atlesque/winterlight/docs/screenshots/measure/desktop-entered.jpg

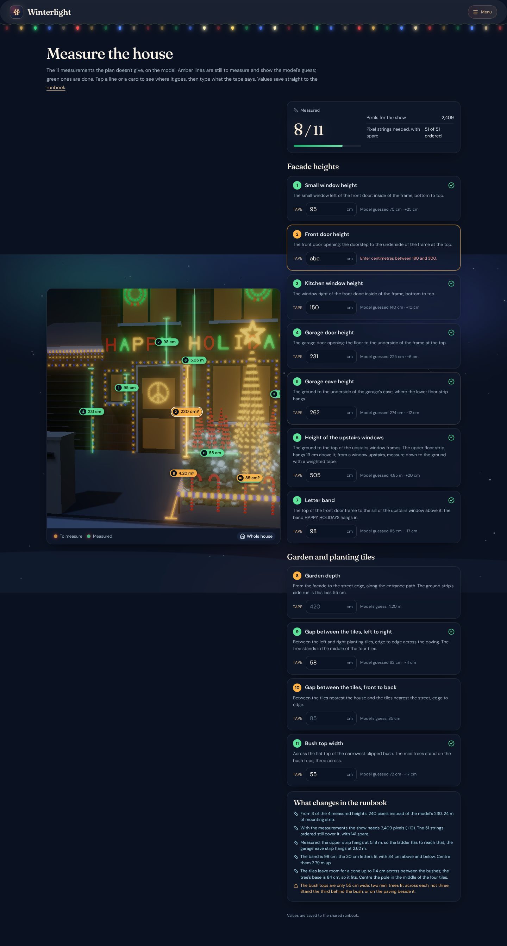
docs/screenshots/measure/desktop-entered.jpg
