atlesque/winterlight/docs/screenshots/wiring/menu-phone.jpg

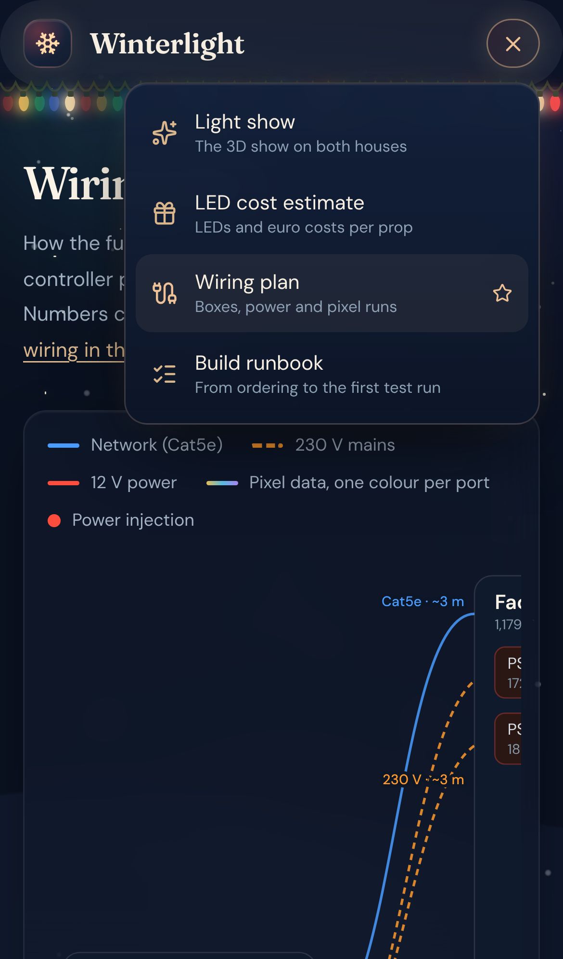
docs/screenshots/wiring/menu-phone.jpg
