atlesque/winterlight/README.md

# Winterlight

A Christmas light show for an 8.50 m Belgian brick-house facade, synced to *Wizards in Winter*. Our house carries the [original filmed house](/?house=original)'s props one for one (all 56 channels) and runs the original's detected timing, so both houses play the same show.

Where they sit (`src/house.js`, geometry in `src/props.js`): yellow/blue icicle strips along the top edge of the two upper windows and under the garage eave (upper and lower floor strips), outlines round the small left window, the door frame, the kitchen window and the garage door (window strips), HAPPY HOLIDAYS in the band between the door and the upper windows, the two circles each in one pane of the upper windows, the peace sign on the front door, a 2.5 m wireframe tree with its star between the planting tiles, eleven mini trees between the facade and the tiles, eight candy canes along the street edge and the ground strip along the left side and front of the shrubbery.

## Run and view

```bash
npm install
npm run dev
```

Open the reported local URL. Both houses live on one page; the toggle in the header shows **Our house**, the **Original** house, or a **Split view** with the original on top and ours below. The choice is kept in the URL (`?house=original`, `?house=split`; our house is the default), and `/original.html` redirects to `/?house=original`. Both houses run one player (`app/composables/useShowPlayer.js`): the original video (or its soundtrack) is the clock, the lights follow `outputs/original-house-cues.json`, and the side panel has the light intensity, all-props-on switch and per-channel board. The view buttons move both cameras. **Overlay video** lays the original model's lights over the original video, so it only shows when the original house is on screen (in split view it overlays the top pane).

The interface is a Nuxt 4 app with Nuxt UI (`app/`): `app/pages/index.vue` is the show page, `app/pages/costs.vue` the LED cost page, `app/pages/runbook.vue` the build runbook, `app/composables/useShowPlayer.js` the shared player, and `app/components/` the header, the prop board and the festive decorations (snow, stars, aurora and the fairy-light garland, which stand still for visitors who prefer reduced motion). The 3D scenes, layouts, cues and cost model stay plain modules in `src/`, so the tests and tools read them as before. `npm run build` runs `nuxt generate`, which prerenders every page (with its SEO tags) into static files in `dist/`, the folder `wrangler.jsonc` serves; `outputs/` is copied to `dist/outputs/`. Fonts (Fraunces and DM Sans) are self-hosted from `@fontsource` packages, so builds need no font service.

The hosted site is [Winterlight](https://winterlight.alexander-df0.workers.dev). Deploy through `npm run deploy`; `npm run deploy:check` builds and checks packaging without publishing. It uses Cloudflare Workers Static Assets, with a small Worker (`worker/index.js`) that only handles `/api/*` for the runbook's shared ticks in a D1 database. Pushes to `main` deploy automatically through Workers Builds, and other branches get a Preview URL through `wrangler preview` using the empty `previews` block in `wrangler.jsonc`.

## Earlier layouts

The old facade layout (arches, stars, poles and outlines, mapped in `outputs/legacy-facade/pixel-map.csv`), its MIDI note show and its extracted `.wltiming` show have been retired from the page; their output files stay in `outputs/` for reference and the code is in git history.

## Original house

The **Original** house (`src/original/scene.js`) rebuilds the house from the filmed show as its own 3D scene, separate from the facade model above, so the original show can be reverse-engineered prop by prop. Its props and how they are addressed:

| Prop | Channels |
|---|---|
| Upper and lower floor strips (yellow/blue) | one per floor |
| Window strips (yellow/blue) | one group |
| HAPPY HOLIDAYS letters (red, green, yellow) | one per letter (13) |
| Christmas circles | left, right |
| Candy canes | one per cane (8) |
| Mini trees | one per tree (11) |
| Ground strip, 30 cm high (yellow/blue) | one |
| Peace sign | one |
| Wireframe tree | one per vertical strip (16) + star |

All 56 channels are described once in `src/original/layout.js`, in the pixel coordinates of a reference still of the final all-on frame (a 2× crop of the video). The 3D model and the detector both read that file. Counts of canes, mini trees and tree strips are estimates from the still.

Because the original video is filmed from a fixed camera, `tools/original/detect.py` samples each channel's region on every decoded frame, learns that channel's own off and on brightness over the whole video, and records each frame's brightness between them in 5% steps, so the show's fades come through rather than being flattened to on/off. The wireframe tree's strips and star are the exception: they only switch on and off, so they are stored at full level. Each strip is read as the average over its wedge of the cone, and only counts as lit when it reaches 60% of the brightest strip in that frame, so glow from a lit strip doesn't switch on its neighbours. Multicolour strips are also classified as yellow, blue or both. There is no smoothing or resampling, so cue changes land on exact video frames (29.97 fps). The page plays them against the hosted soundtrack, which was extracted from the same video.

```bash
# Check the regions against a frame of the video, then detect a range.
python3 -I tools/original/detect.py source.mp4 --overlay work/original/overlay.png --at 180
python3 -I tools/original/detect.py source.mp4 --out outputs/original-house-cues.json --levels work/original/levels.csv
```

Light spills between neighbouring props, so each channel has a floor below which it counts as off: 10% for the floor strips, 25% for the canes and circles, 50% for the letters (they catch up to ~46% spill from the icicles above) and 45% for the ground strip (snow lit by the icicles and mini trees). The mini trees stand closer together than their glow is wide, so each is watched along its centre line by mean brightness with a 45% floor. The window-strip regions stop short of the icicles, and the peace sign is watched only along its upper half, above the mini-tree tops, for the same reason. `outputs/original-house-cues.json` covers the whole video, 0:00–3:05 (all 5,569 frames).

The side panel plays the original video with its own sound, and while it plays the lights follow the frame on screen (`src/original/video-clock.js`). The site hosts a 720p copy at `public/media/wizards-in-winter-video.mp4` (about 13 MB, every source frame and timestamp kept). If it is ever missing, the page asks for a local MP4 once and keeps it in that browser, and without any video the hosted soundtrack drives the lights. The hosted copy was made with:

```bash
ffmpeg -i source.mp4 -map 0:v:0 -map 0:a:0 -vf scale=1280:720:flags=lanczos -c:v libx264 -preset slow -crf 27 -pix_fmt yuv420p -fps_mode passthrough -c:a aac -b:a 96k -movflags +faststart public/media/wizards-in-winter-video.mp4
```

Seen from the camera, tree strips at angle θ and π−θ (front and back of the cone) overlap, so detection reads seven lines across the tree and lights both strips of each lit line. In the video the light goes round the cone: a 60° slice chases round it (1:17–1:29, 2:12–2:26, 2:30–2:52), four or two arms turn together (2:53–3:02), and short sweeps start as two points on one side that run round the front and the back and meet on the other to light the whole tree. `tools/original/tree_motion.py` (run by the detector, or on its own over a cue file) gives each passage of twelve or more changes that motion: it fits a slice or evenly spaced arms turning round the cone, steadily in one direction, and lights in each frame the strips nearest that pattern that still look exactly like the video from the front. Shorter passages keep both sides lit, so the two points run round the front and the back. Which way the light turns can't be seen from the front (a pattern turning one way looks like its mirror image turning the other), so the front moving left to right is taken.

## Current deliverables

- [Approved build guide](outputs/christmas-show-project.md) and [printable HTML](outputs/christmas-show-project.html)
- [Facade/plan layout](outputs/layout.svg) and [wiring diagram](outputs/wiring.svg)
- [Pixel/channel map](outputs/legacy-facade/pixel-map.csv), [controller port settings](outputs/controller-config.csv) and [power feed schedule](outputs/power-feeds.csv)
- [Revised parts checklist](outputs/revised-bom.csv) and [parts review](outputs/parts-critical-review.md)
- [Sourcing and cost changes](outputs/eu-sourcing-research.md) and [technical research](outputs/technical-research.md)
- [Playback guide](outputs/source-playback-guide.md), [sampling provenance](outputs/source-mapping.json), [every-frame worksheet](outputs/source-frame-summary.csv) and [cue assignments](outputs/cue-worksheet.csv)
- [Integrity report](outputs/source-integrity-report.json), [bank manifest](outputs/controller-banks/manifest.json) and [playback audit](outputs/source-playback-audit.json)

Historical price/regulatory research is dated explicitly; it is not a current delivered purchase quote. Prior screenshots depict earlier revisions unless identified as the approved facade edition.

## Rebuild and validate

```bash
npm test
npm run build
```

## LED cost estimate

`/costs.html` recommends LEDs for every prop of our house and prices them in euro per prop, per group and in total, including wiring, power injection, controllers, power supplies, boxes and the show computer. Ticking props or groups off updates every total. Pixel counts, frame lengths and cable runs come from `src/props.js`; parts and prices (with shop links and the date they were checked) live in `src/costs/catalog.js`, the cost model in `src/costs/estimate.js` and the page in `app/pages/costs.vue`.

## Build runbook

`/runbook.html` is the step-by-step plan for building the show for real: plan and measure, order the parts (in two waves, with order-by dates), deliveries, a bench test, building the props, hanging and placing them, configuring Falcon Player and xLights, and a test run before show night. Each purchase links to its shop, is tagged as a private or business expense (click the tag to switch it) and adds to the private and business subtotals. The measuring steps list the lengths the 2021 plan gives (everything along the facade and the garden's width, via `src/house.js`) and the ones it can't (heights, the forecourt depth and the planting tiles), with the model's guess to check with a tape. Ticks and tag switches are shared across devices: the page reads and writes `/api/runbook`, which `worker/index.js` serves from the `winterlight` D1 database (`RUNBOOK_DB`, schema in `migrations/`). The runbook page, the measure page and their API (`/runbook`, `/runbook.html`, `/measure`, `/measure.html`, `/api/runbook`) sit behind the Cloudflare Access application **Winterlight runbook**, which only lets Alex's email in (one-time PIN); the Worker also refuses requests that lack the identity header Access adds. The rest of the site stays public. Orders already placed and decisions already made (`PRESET` in `src/runbook/runbook.js`) start ticked; the database only stores changes to those defaults. Without the Worker (`npm run dev`, preview builds) the page keeps ticks in the browser instead. To try the API locally, put `RUNBOOK_OPEN=1` in `.dev.vars` (no Access locally), run `npx wrangler d1 migrations apply winterlight --local`, `npm run build` and `npx wrangler dev`. `/measure.html` shows every measurement still to take with a tape (opening heights, the upstairs windows, the garage eave, the letter band, the garden depth, the gaps between the planting tiles and the bush tops) as dimension lines on the 3D model, amber with the model's guess until measured and green after. Tap a line or a card to fly the camera to it and type the value in centimetres. Values are stored in the same D1 database (`measurements` table, `migrations/0002_measurements.sql`) through `/api/runbook`; the measurements, their positions on the model and what they change live in `src/measures/measures.js`. In the runbook a measuring step ticks itself once all its values are in, its tape lines show the measured values, and the steps that depend on them show the updated numbers: the window outline and ground strip pixel counts, whether the pixel strings and mounting strip ordered still cover the show, the ladder height, and whether the letters, the tree and the mini trees fit. Quantities come from the cost model for the full show, in the units the shops sell; the chapters, shops, delivery times and expense tags live in `src/runbook/runbook.js` and the page in `app/pages/runbook.vue`.

The coro props (Christmas circles, peace sign, candy canes and tree star) have full-size cutting templates in `outputs/templates/` (SVG and PDF, one per shape, with every 12 mm pixel hole marked and a 100 mm bar to check the print scale), linked from the runbook's build chapter. They are drawn from the same bulbs and frames as the 3D model; regenerate them after a prop changes with `node tools/templates/make.mjs` (the PDFs need Playwright). The HAPPY HOLIDAYS letters are ProPixeler's ready-made 30 cm coro letters, so they have no template.

## Show software

`/software.html` explains the software side of the real show with one data diagram: the Raspberry Pi running Falcon Player in the garage, the switch, the two Baldrick 8 controllers (facade board and garden box), the USB sound card and FM transmitter, and the laptop, home router and this site, which are only used for setup. It lists what runs where and lays out the proposed conversion from the detected cue file to a Falcon Player sequence (`.fseq` at 40 fps, one RGB channel block per controller over DDP), with each step marked done, decided or proposal, and what is still to decide. Controllers, ports and pixel counts come from the wiring plan; the channel map and sequence numbers are worked out in `src/software/plan.js`, and `tests/software.test.js` checks them against the cue file. The page is public.

## 3D prints

`/print.html` lists the PETG parts the garden props still need, for the Bambu Lab A1 (256 mm bed): base rings and top caps for the mini trees; the wireframe tree's crown hub, star holder and a base ring of 16 puzzle segments, four of them with a brick tray; a two-brick base per candy cane; and a brick foot and post for every ground strip post. The paving in front of the house is stone, so nothing is staked: the props stand on printed trays weighed down with concrete paving bricks (22 × 11 × 8 cm), the tree's pole in a parasol base, and only the mini trees push a rod into their bush. The 3D view shows each finished prop (`src/print/assembly.js`: the printed parts where they sit once built, with the strip, coro, pixels, bricks and pole) or each part on the bed as it prints.

Each part is an OpenSCAD file in `tools/print/` (shared channel, tray and ring code in `lib.scad`); `src/print/parts.js` says how many to print and passes the model's sizes (tree radius and height, mini-tree size, strip height) in as `-D` overrides, so the parts follow `src/house.js`. `node tools/print/make.mjs` (needs `openscad`, and `zip` for the bundle) renders `outputs/print/<part>.stl`, a copy of each `.scad` with those values filled in, `manifest.json` (size and grams) and `winterlight-prints.zip`, and refuses a part bigger than the bed. The slots are drawn for a 25 × 2 mm mounting strip, 3 mm coro, a 32 mm pole and 22 × 11 × 8 cm bricks; change `strip_w`, `strip_t`, `pole_d` or the brick size once those are measured and render again. The page is public: it isn't behind the runbook's Access application, and the runbook's build and placing steps link to it.

## SEO and sharing preview

`app/pages/index.vue` sets (with `useHead`/`useSeoMeta`, prerendered into the HTML) the title, description, canonical URL, Open Graph and Twitter card tags; the page swaps `document.title` as the house toggle changes. `public/original.html` is only a redirect to `/?house=original` with a canonical link there. `public/og-image.jpg` (our house) and `public/og-image-original.jpg` (the original house) are 1200×630 renders of the site's own 3D scenes. The pages also share `favicon.svg`, `apple-touch-icon.png`, `robots.txt` and `sitemap.xml`.

To regenerate the share images after a model changes: `npm run build`, start `npm run preview` (serves `dist/` on port 4173), then run `node tools/og-image/render.mjs` (needs Playwright). The page list, show moment and card text live at the top of that script; the card layout is `tools/og-image/card.html`.

To add a new page: add a Vue file under `app/pages/`, copy the `useHead`/`useSeoMeta` block from `app/pages/index.vue`, change the title, description, canonical, `og:url`, `og:title`, `og:description` and the two `twitter:` text tags, add the page to `tools/og-image/render.mjs` if it should have its own image, add its URL to `public/sitemap.xml` and its route to `nitro.prerender.routes` in `nuxt.config.ts`.
