atlesque/winterlight/tools/transcription/requirements-desktop.txt

# Torch is reused from the desktop CUDA runtime; never install model weights here.
numpy==2.4.6
scipy==1.17.1
librosa==0.11.0
soundfile==0.13.1
pretty-midi==0.2.11.post0
mir-eval==0.8.2
mido==1.3.3
transformers==4.43.4
huggingface-hub==0.36.2
onnxruntime==1.31.0
ml-collections
beartype
rotary-embedding-torch
einops
absl-py
soxr
safetensors
PyYAML
tqdm
julius
lameenc
openunmix
dora-search
omegaconf
hydra-core
hatchling
setuptools
wheel
resampy

matplotlib
torchlibrosa==0.1.0
