atlesque/winterlight/outputs/approved-facade-playing.png

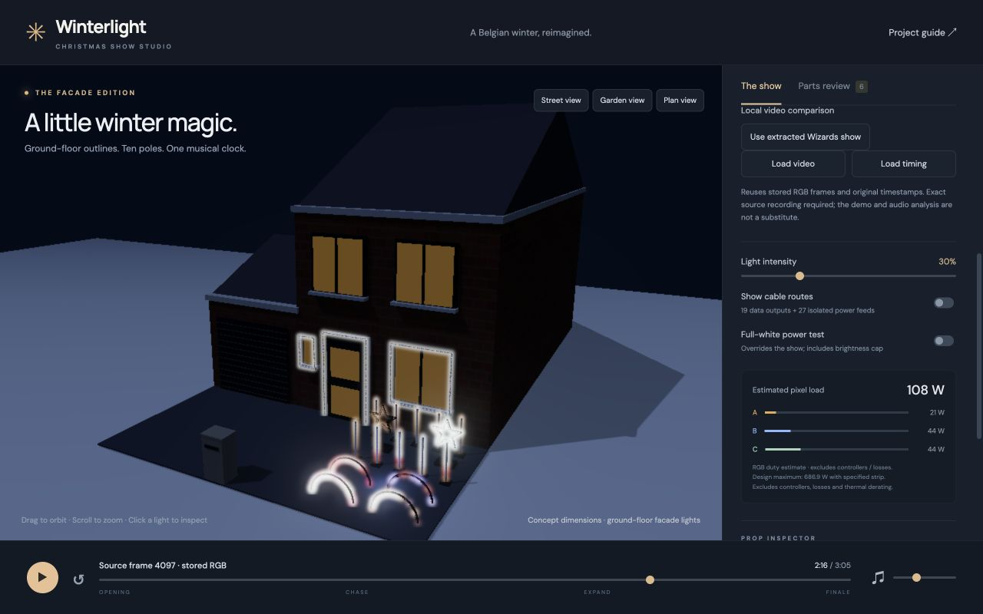
outputs/approved-facade-playing.png
