atlesque/winterlight/outputs/cloudflare-preview.jpg

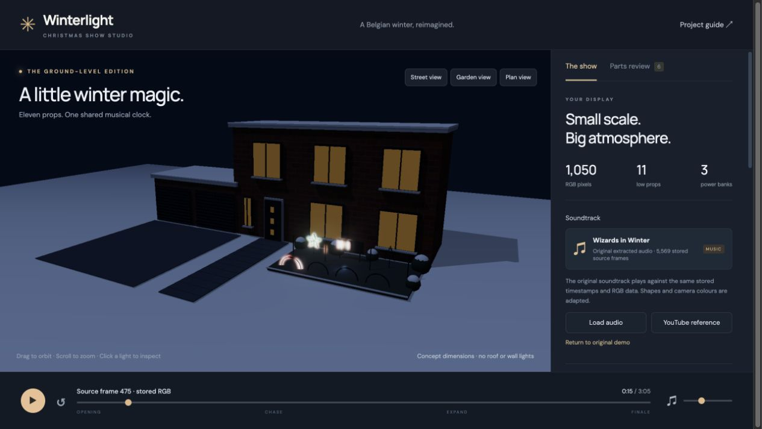
outputs/cloudflare-preview.jpg
