atlesque/winterlight/outputs/house-plan-preview.jpg

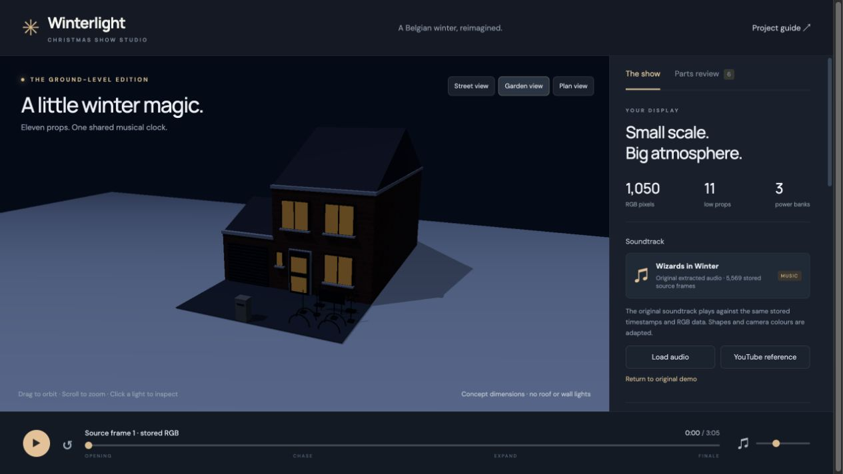
outputs/house-plan-preview.jpg
