atlesque/winterlight/outputs/new-props-preview.png

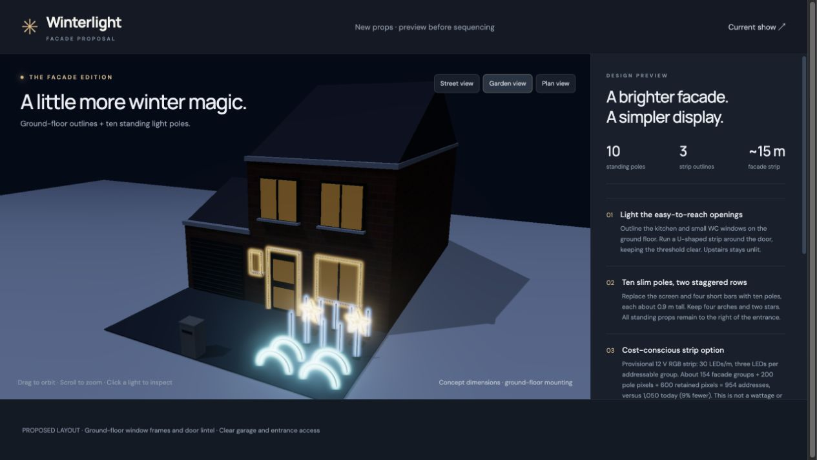
outputs/new-props-preview.png
