atlesque/winterlight/outputs/simulator-preview.jpg

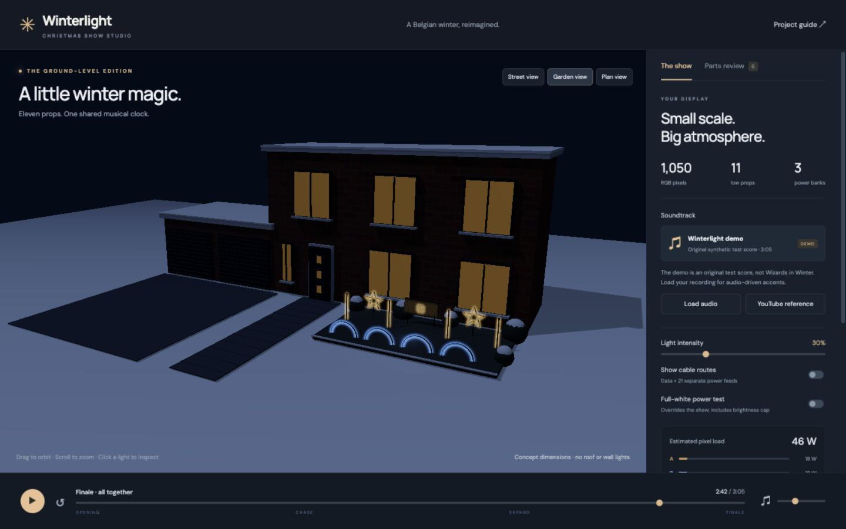
outputs/simulator-preview.jpg
