atlesque/winterlight/outputs/source-show-preview.jpg

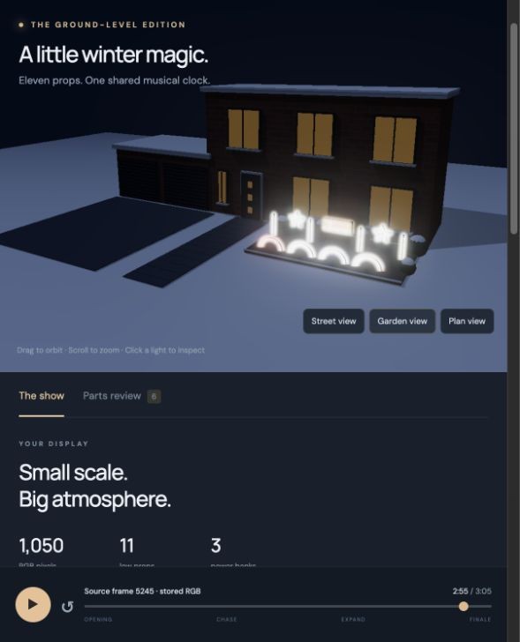
outputs/source-show-preview.jpg
