atlesque/winterlight/outputs/source-timing-diagnostic.jpg

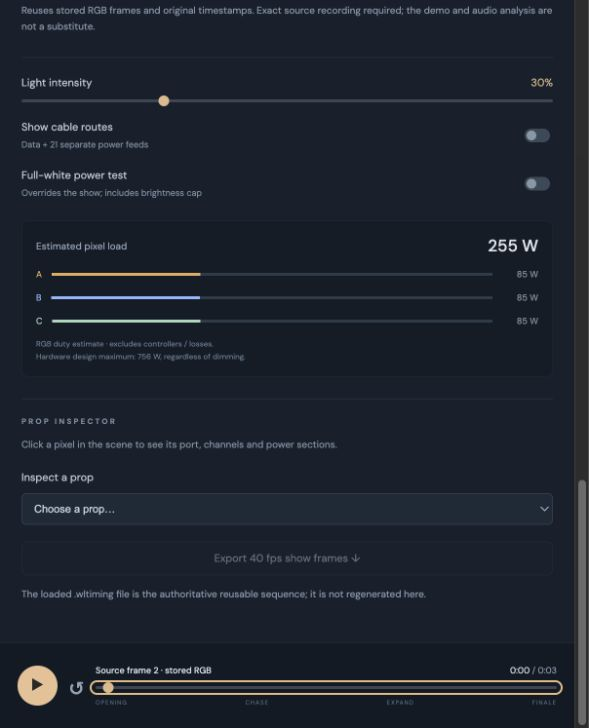
outputs/source-timing-diagnostic.jpg
