atlesque/winterlight/outputs/timing-integrity-rejection.jpg

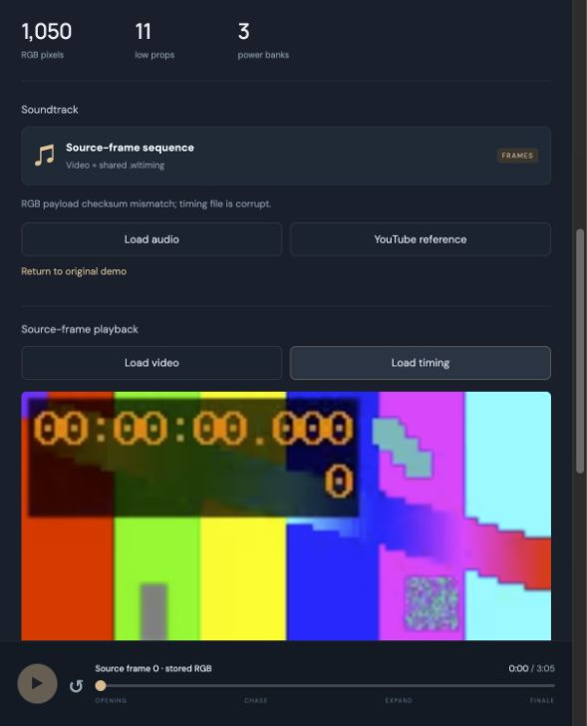
outputs/timing-integrity-rejection.jpg
