atlesque/winterlight/public/og-image-original.jpg

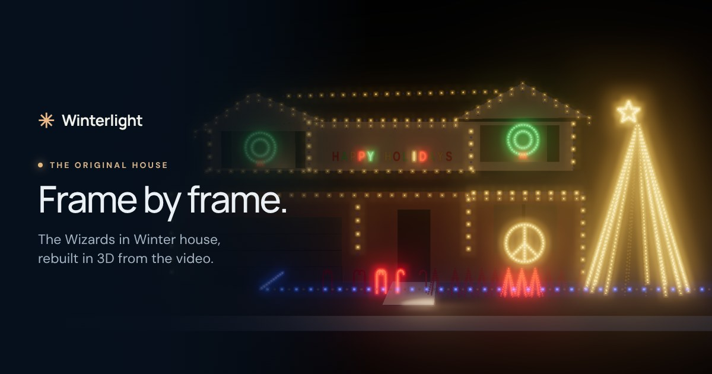
public/og-image-original.jpg
