atlesque/winterlight/public/og-image.jpg

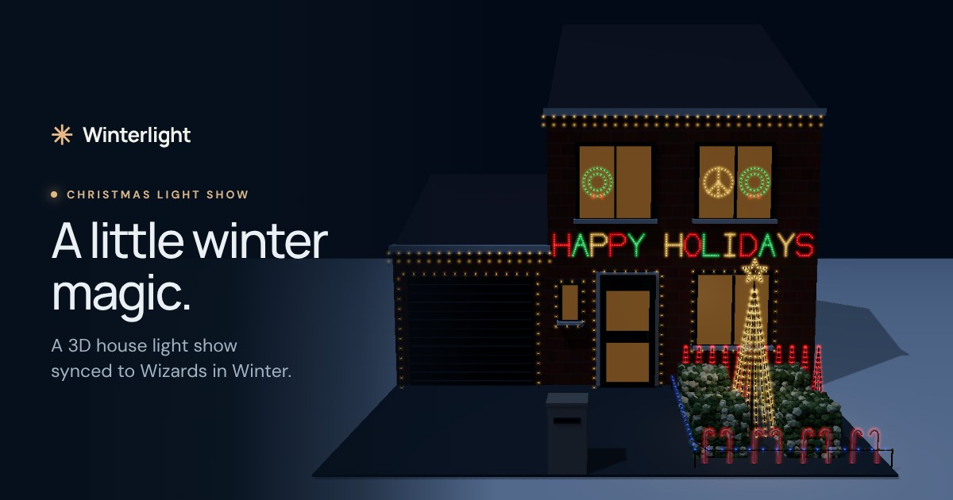
public/og-image.jpg
