atlesque/winterlight/outputs/print/minitree-base.stl

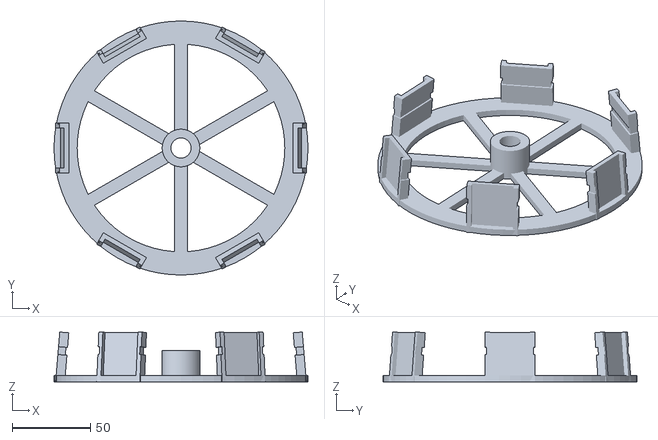
[picture p13: CAD file, 2026-11-13]
outputs/print/minitree-base.stl
162.0 x 162.0 x 31.9
