atlesque/winterlight/outputs/print/fence-post.stl

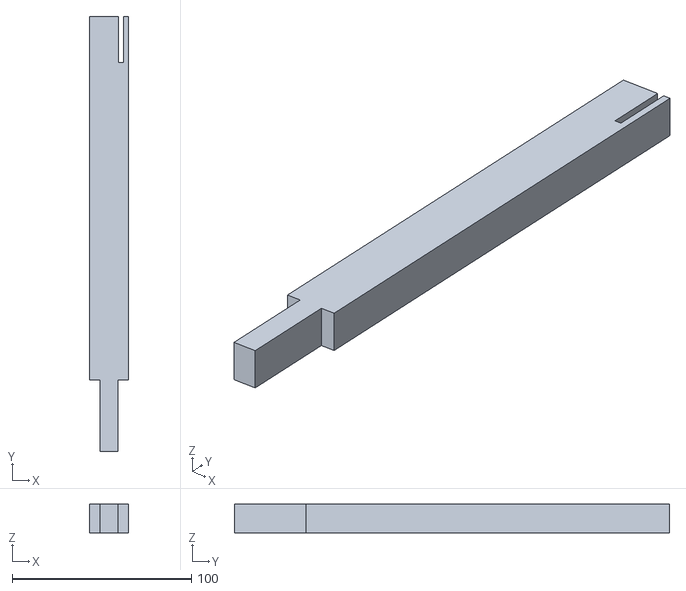
[picture p14: CAD file, 2026-11-07]
outputs/print/fence-post.stl
22.0 x 242.9 x 16.0
