atlesque/winterlight/outputs/print/tree-ring.stl

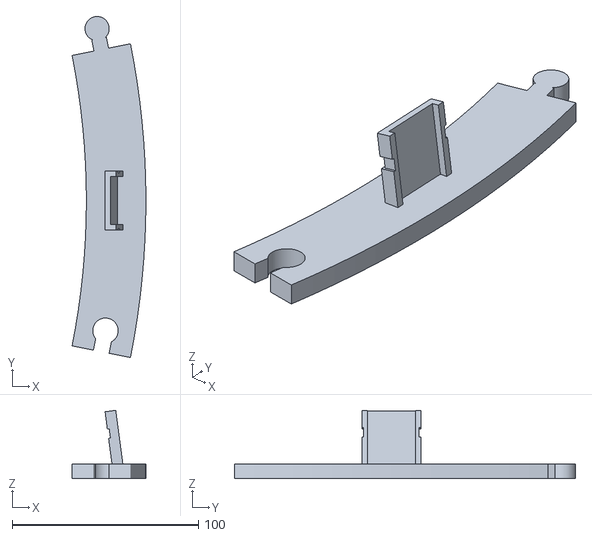
[picture p15: CAD file, 2026-11-07]
outputs/print/tree-ring.stl
39.7 x 183.2 x 36.7
