atlesque/winterlight/outputs/print/tree-crown.stl

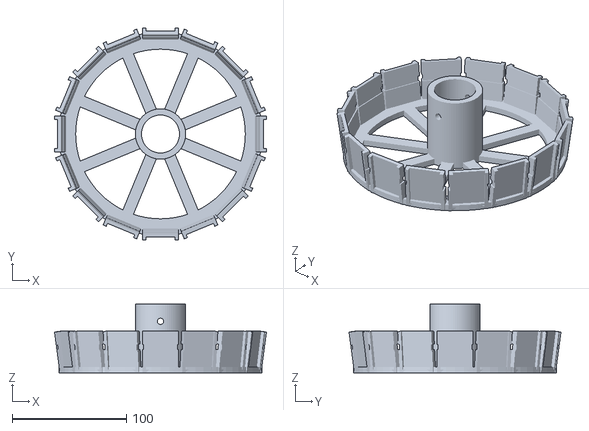
[picture p16: CAD file, 2026-11-07]
outputs/print/tree-crown.stl
185.5 x 185.5 x 60.0
