atlesque/winterlight/outputs/print/cane-base.stl

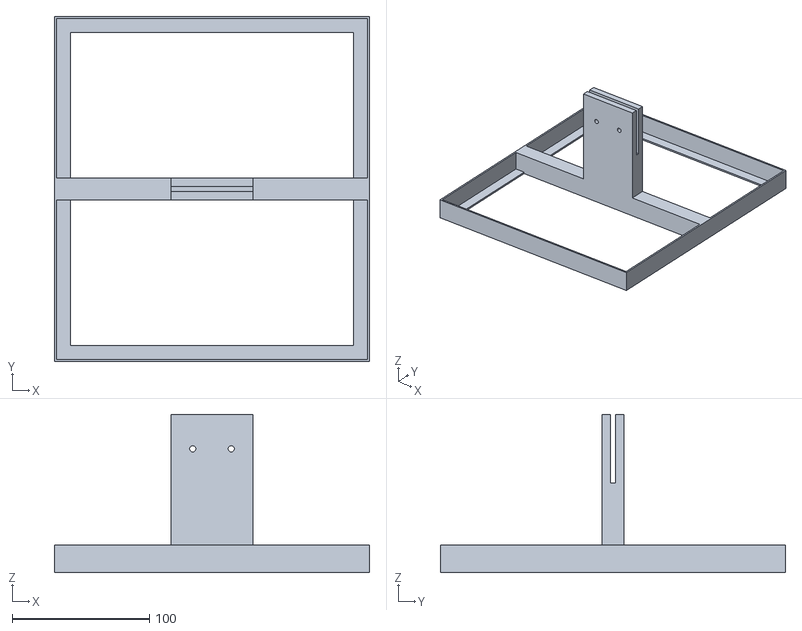
[picture p17: CAD file, 2026-11-07]
outputs/print/cane-base.stl
229.2 x 251.2 x 115.0
