atlesque/winterlight/docs/screenshots/wiring/garage-open-street.jpg

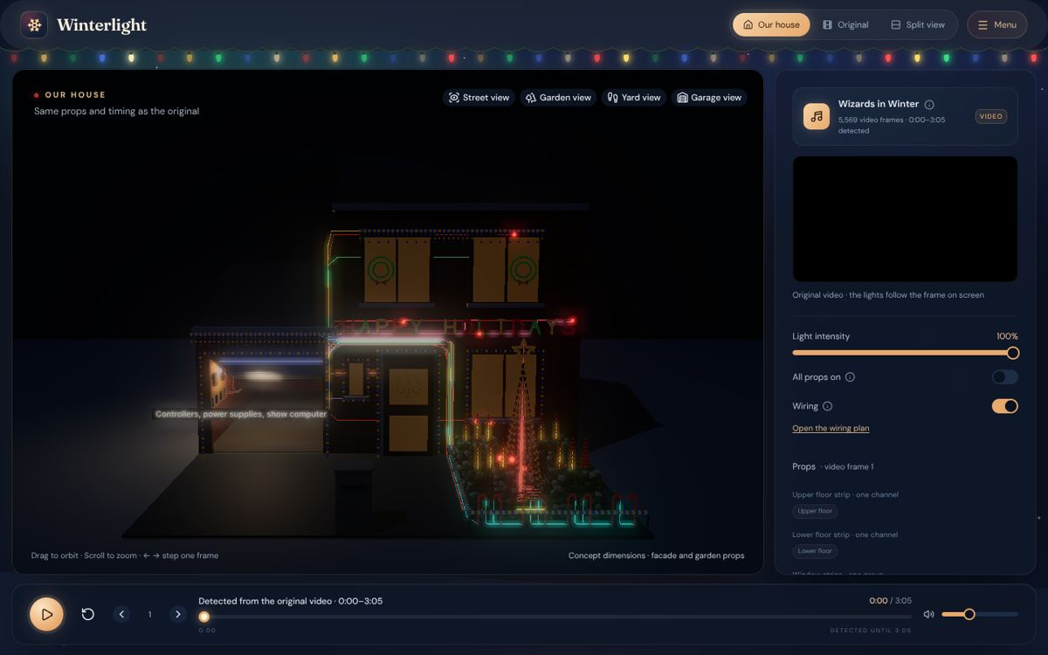
docs/screenshots/wiring/garage-open-street.jpg
