atlesque/winterlight/docs/screenshots/wiring/wiring-plan-desktop.jpg

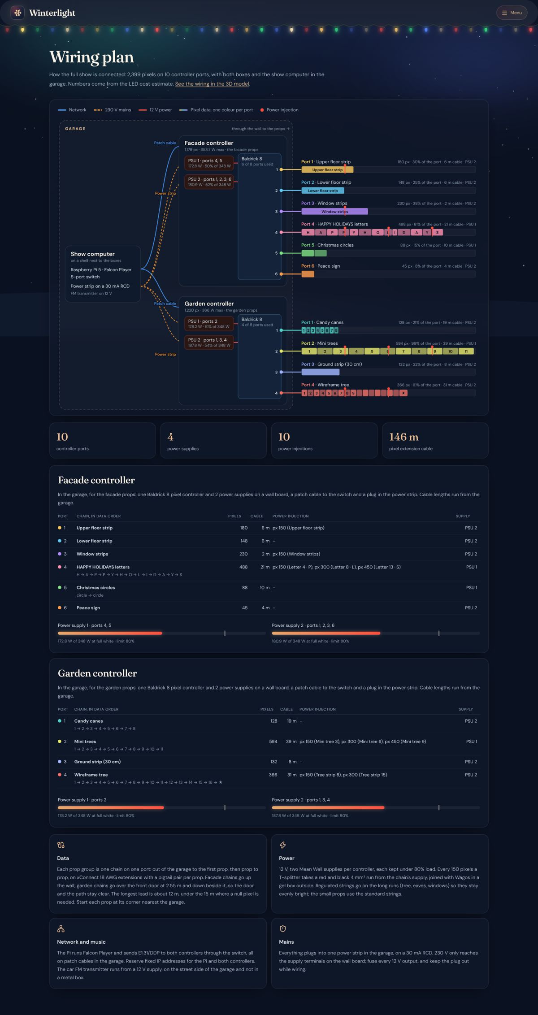
docs/screenshots/wiring/wiring-plan-desktop.jpg
