atlesque/winterlight/outputs/simulator-wiring-preview.jpg

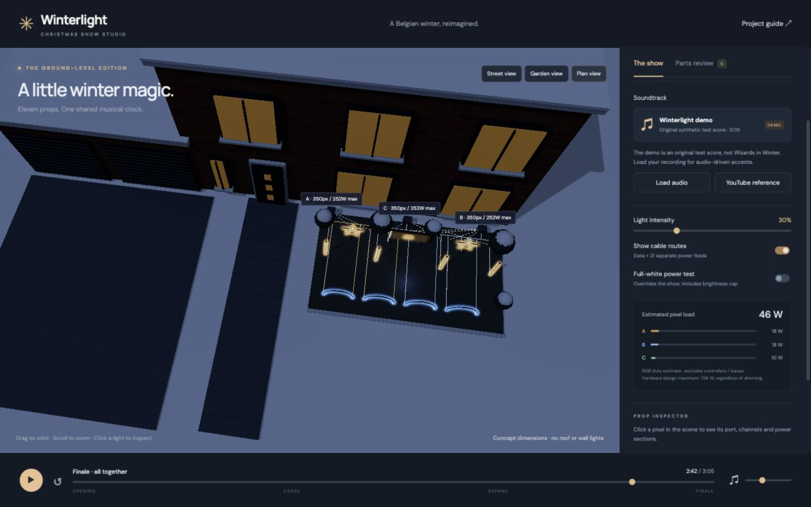
outputs/simulator-wiring-preview.jpg
