atlesque/winterlight/outputs/simulation-validation.md

# Approved facade simulation validation — 9 October 2026

The main show uses four arches, two stars, ten poles and three ground-floor frame outlines: 19 props, 954 addresses and 2,862 channels. The preview imports the same approved geometry. No former bar or screen model is active.

The physical/layout checks cover contiguous global channels, unique ports, pole/base placement inside the right garden, ground-floor-only strip heights, clear garage/entrance access, independent bank allocations and coverage by 27 bounded power sections. Facade routes cross above the lintel or remain on the facade plane, not across entrance paving.

The full-white arithmetic maximum is 686.88 W: A=264.96 W, B=244.80 W, C=177.12 W. This is conditional on bullets <=0.72 W/node and grouped strip <=7.2 W/m at 10 addresses/m. It excludes controller overhead/losses and is not a voltage-drop, fuse, thermal or field measurement.

Nineteen automated tests pass, including deterministic demo frames, seeking, audio onset behavior, timing integrity, exact native PTS/audio tail, current map hash and every frame of bank recombination. Browser playback and screenshots are recorded separately in source-playback-audit.json and approved-facade screenshots. Build packaging includes the main show, static preview and current project outputs.

Facade geometry, mounting access, cable lengths and ballast remain site estimates. No real controller has been connected. WLT2 partitions require a verified hardware adapter; physical electrical and audio/light commissioning remain outside the software validation.
