atlesque/winterlight/outputs/templates/candy-cane.pdf

# Candy cane · cut 8 · 16 holes of 12 mm

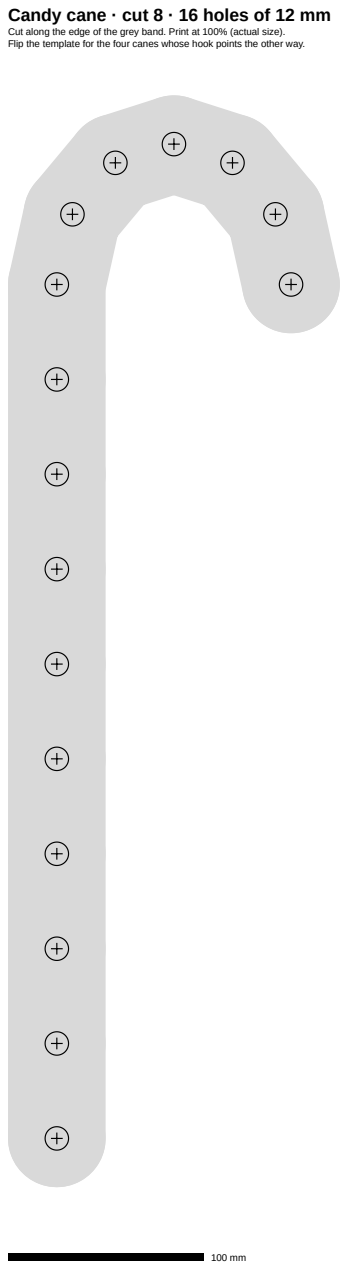
[picture p21: page 1]

Cut along the edge of the grey band. Print at 100% (actual size).
Flip the template for the four canes whose hook points the other way.
