atlesque/winterlight/outputs/templates/christmas-circle.pdf

# Christmas circle · cut 2 · 42 holes of 12 mm

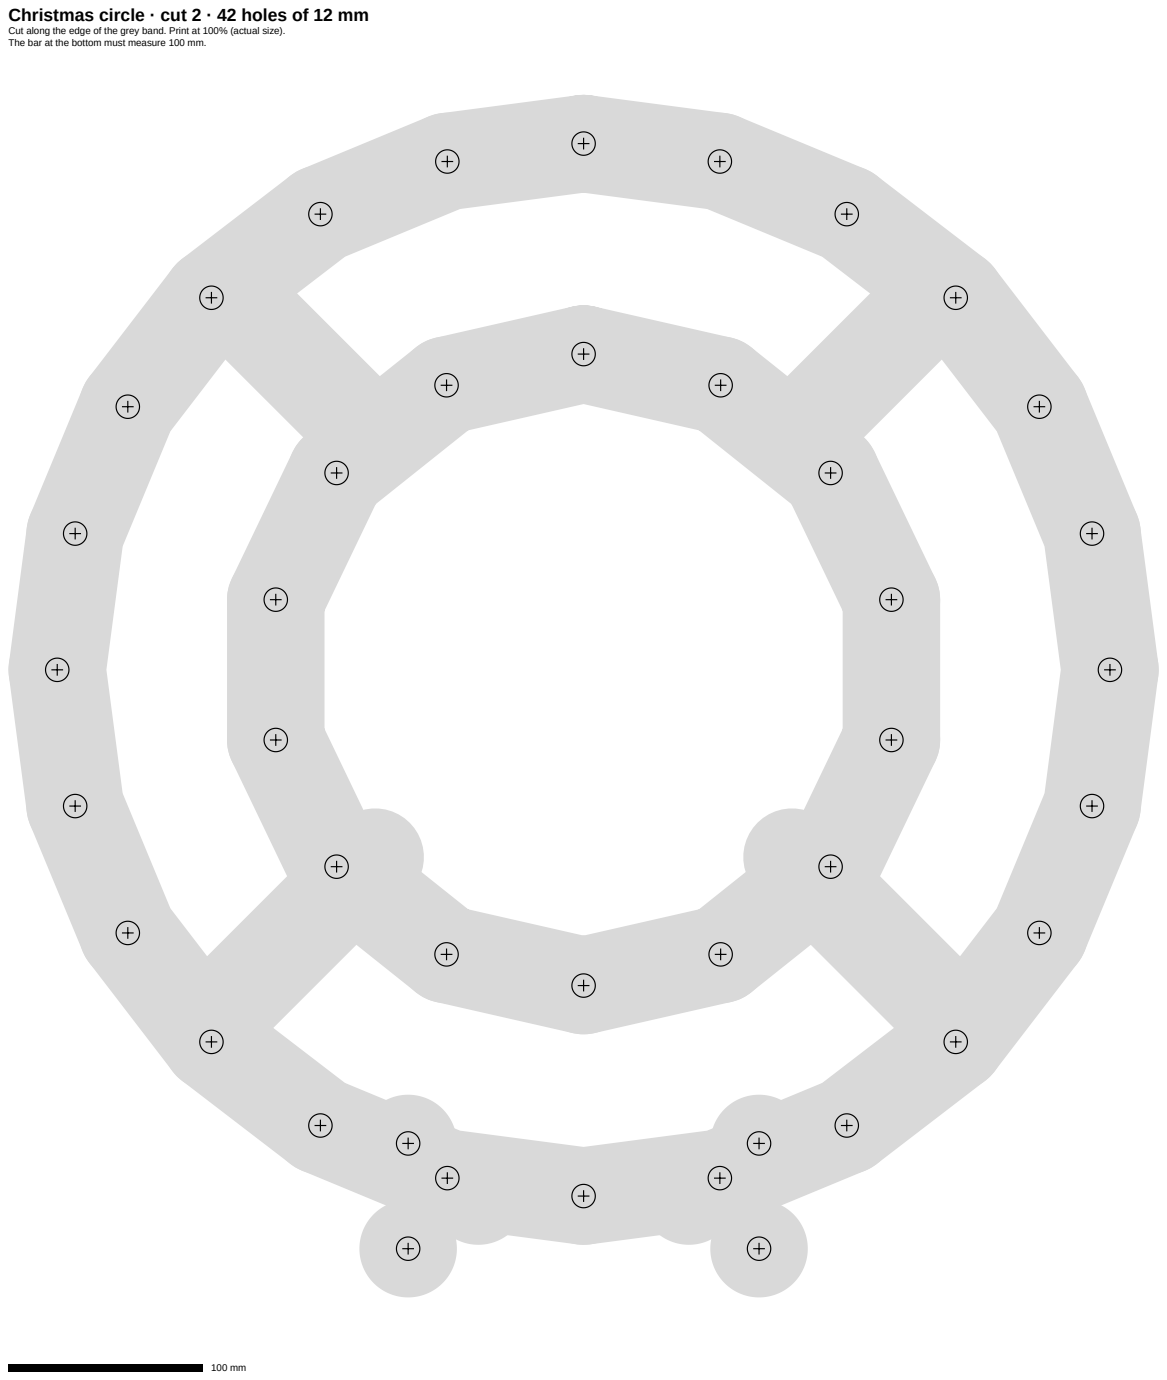
[picture p22: page 1]

Cut along the edge of the grey band. Print at 100% (actual size).
The bar at the bottom must measure 100 mm.
