atlesque/winterlight/outputs/templates/tree-star.pdf

# Tree star · cut 1 · 30 holes of 12 mm

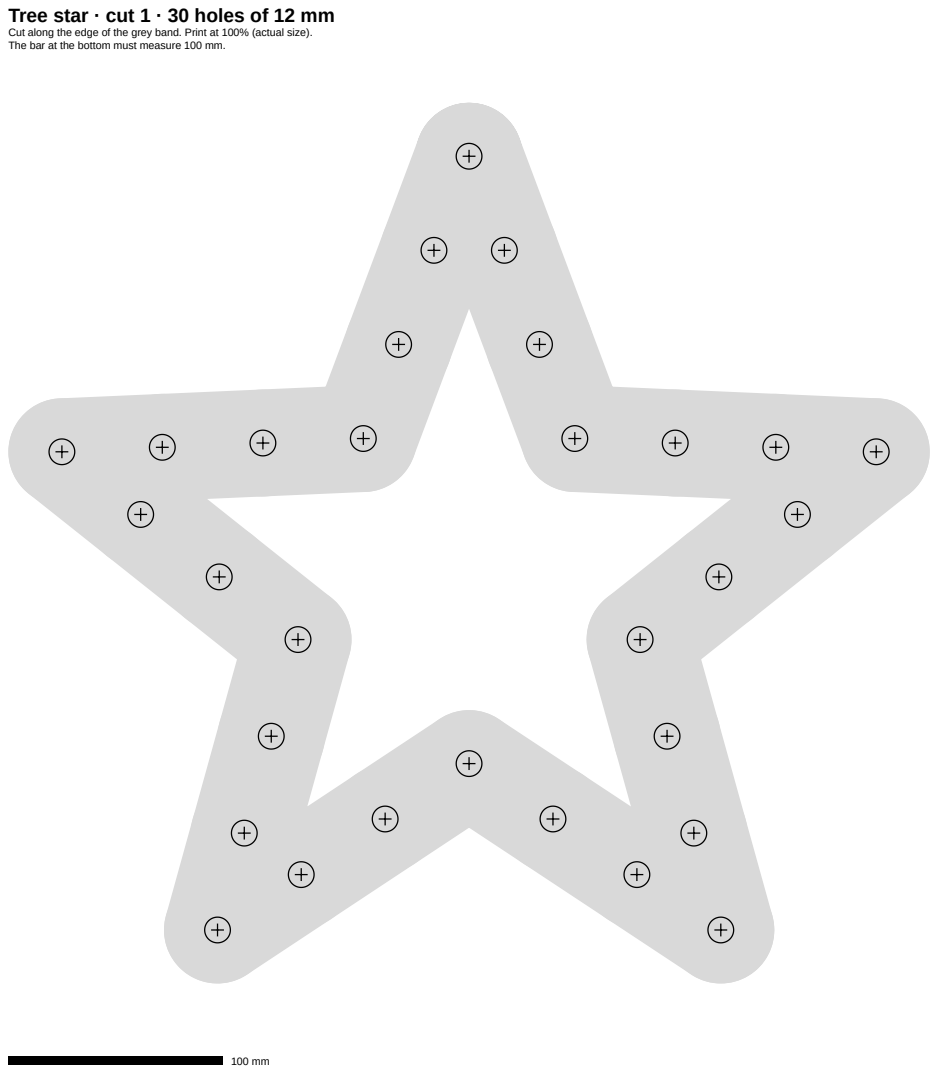
[picture p23: page 1]
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
