atlesque/winterlight/(commit log)

2026-10-08 Add Winterlight Christmas show project and build documentation
    [cue-worksheet.csv, pixel-map.csv]
2026-10-08 Add Three.js Christmas show simulator and critical parts review
    [revised-bom.csv]
2026-10-08 Add immutable source-frame timing playback and audit
2026-10-09 Extract and verify all source frames for Wizards light simulation
    [source-frame-summary.csv]
2026-10-09 Use approved facade props and preserve Wizards source timing (#1)
    [controller-config.csv, cue-worksheet.csv, pixel-map.csv, power-feeds.csv, revised-bom.csv, source-frame-summary.csv]
2026-10-09 Add the four front-yard planting tiles and move the props clear of them (#4)
    * Add the four front-yard planting tiles to the house model
    Four 0.8 m cut-outs in the slate paving right of the door, each with a
    slim variegated shrub and four boxwood balls, placed from the street photo.
    Claude-Session: https://claude.ai/code/session_019Q3KuR9r1xszaTprJtkoLG
    * Move the standing props clear of the planting tiles
    Arches now stand in the clear bands behind and in front of the second
    tile row, stars move just ahead of the first row, and the back poles sit
    in the gaps between the tiles. Garden cable runs use the corridors between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
    [power-feeds.csv]
2026-10-09 Rebuild the original filmed house and detect its prop timing from the video (#5)
    * Add the original filmed house as its own 3D scene with a per-prop video detector
    The original house gets its own page with every listed prop as a separately
    addressable channel. A detector samples each prop's region on every frame of
    the statically filmed video and writes frame-exact on/off cues for the page.
    Claude-Session: https://claude.ai/code/session_01KLXYpNcPKJmsdaf3YV32w9
    * Detect the first 20 seconds of the original video per prop
    Aligns the detection regions to the real video, trims window-strip regions
    away from the icicles, se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
2026-10-09 Original house: seek anywhere in the video, and lift the tree star off the strips (#7)
    * Original house: make the playhead seek anywhere in the video
    - The playhead stopped following the show once it had been clicked,
    because it skipped updates while focused. It now only holds still
    while it is being dragged.
    - Seeks are clamped to the media length.
    - If the server doesn't serve byte ranges, the browser can only seek
    within what it has downloaded (seekable 0-0 in a test against such a
    server). The page now detects that and plays the whole video from
    memory so any point can be reached.
    Claude-Session: https://cla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
2026-10-09 Original house: the wireframe tree only switches on and off (#8)
    The tree's strips and star never fade, so their cues are now stored at full
    level whenever they are lit instead of in 5% steps. A strip counts as lit
    from 30% of its range: its usual on level is about half the brightest
    frames, where the camera saturates. Strip regions now stop a quarter above
    the base, so the mini trees' glow no longer reads as the left strips.
    Cues re-detected for the whole video.
    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
2026-10-09 Original house: light only the tree strips that are clearly lit
    A lit strip's glow spread onto the neighbouring strips' detection lines,
    so the model lit most of the tree where the video shows a few strips (for
    example at 2:54). Each strip is now read as the average brightness of its
    wedge of the cone, and only counts as lit when it also reaches 60% of the
    brightest strip in that frame. The outermost lines, closer together than
    a strip is wide, share one wedge. Cues re-detected for the whole video.
    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
2026-10-09 Replace our house's props with ones modelled on the original house
    A 2.5 m wireframe tree with its star between the planting tiles, HAPPY
    HOLIDAYS letters under the eave, a peace sign and a Christmas circle in the
    upper windows, a circle on the front door, yellow/blue eave strips (icicles
    on the garage), six candy canes and six mini trees. The arches, stars,
    poles and window/door outlines are gone.
    Neither timing source maps onto the new props, so the page defaults to a
    new all-props-lit view and the MIDI and filmed timings are disabled. The old
    channel map moves to outputs/legacy-facade/ for the extracted-show tests.
    Cla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
    [pixel-map.csv]
2026-10-09 Run the original house's props and timing on our house
    Every one of the original's 56 channels now has a counterpart on our
    house with the same id, colours and addressing: icicle strips on both
    eaves, outlines round the small window, door, kitchen window and garage,
    HAPPY HOLIDAYS between the door and the upper windows, circles and peace
    sign each in one upper-window pane, the wireframe tree and star, 11 mini
    trees, 8 canes and the ground strip along the shrubbery. The page reads
    the original's cue file and video clock and copies its interface.
    The MIDI show, YouTube reference, wltiming playback, power banks and the
    props preview page are removed with their tools and tests.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
    [pixel-map.csv]
2026-10-09 Tree light goes round the cone; peace sign on the door; upper strip on the window tops
    The camera sees the wireframe tree side on, so detection lit the front and
    back strips of every lit line together and the chases looked like mirrored
    pulses. tools/original/tree_motion.py now fits each long passage as a slice
    or evenly spaced arms turning round the cone and lights, frame by frame, the
    strips nearest that pattern that still look exactly like the video from the
    front. Short sweeps keep both sides lit, as two points running round the
    front and the back that meet to light the whole tree. The detector runs it,
    and it re-timed the one shared cue file in place (only tree strips changed).
    On our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
2026-10-10 Default light intensity to 100%; denser, brighter house strips (#11)
    The upper floor, lower floor and ground strips now carry twice the bulbs,
    keep their alternating blue and orange, and glow brighter than the other
    props: driven 1.6x harder on our house, and with bigger bulbs on the
    original house, whose strong bloom would wash a harder drive out to white.
    Detected levels still scale them, so fades show. Timing is unchanged.
    Claude-Session: https://claude.ai/code/session_01Aa43FMhSa4Nfaw9iRPHa2p
2026-10-10 Frame-by-frame stepping; one shared player for both houses (#12)
    Both pages now run src/player.js: the same controls, cue file, video clock
    and transport. Each page brings only its 3D scene and wording. New frame
    step buttons and arrow / comma / period keys pause and land mid-frame.
    Claude-Session: https://claude.ai/code/session_013QULrU2JkqJpPJgajQfhna
2026-10-10 Our house: original-bright floor strips, darker night, mini trees on the bushes (#13)
    The upper, lower and ground strips get 1.5x bulbs and a 1.5x wider glow so
    they read as bright as on the original house. The sky, moonlight, snow and
    window glow are turned well down, so the lights carry the scene. The eleven
    mini trees, hidden behind the clipped bushes, now stand on the bush tops
    (three per bush, two on the back right one), listed left to right so chases
    still run across. Timing is unchanged.
    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
2026-10-10 One page for both houses: our house, the original, or split view; matched prop brightness (#14)
    * One page for both houses: toggle between ours, the original and a split view
    The header toggle shows our house, the original filmed house, or both stacked
    (original on top). The view buttons move both cameras; Overlay video only shows
    while the original is on screen and overlays its pane in split view. The choice
    is kept in ?house=, and /original.html redirects to /?house=original.
    Also sizes the original scene's canvas to its pane, so it is no longer drawn
    oversized and cropped on high-DPI screens.
    Claude-Session: https://c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
2026-10-10 LED cost estimate page: LED picks and euro costs per prop, group and total (#15)
    Claude-Session: https://claude.ai/code/session_01BTk411kXeKCeq2fjDRnnRY
2026-10-16 Rewrite the UI in Nuxt 4 + Nuxt UI with a festive Christmas look (#16)
    * Rewrite the UI in Nuxt 4 and Nuxt UI with a festive look
    Both pages (the light show and the LED cost estimate) are now a Nuxt 4 app
    with Nuxt UI, generated as static files into dist/ for Cloudflare as before.
    The player, sidebar, transport and cost page keep every control and URL
    (?house=, /original.html, /costs.html); the 3D scenes, cues and cost model in
    src/ are unchanged. Adds subtle snow, stars, aurora and a twinkling garland
    that stand still for reduced motion, and self-hosted Fraunces/DM Sans fonts.
    Claude-Session: https://claude.ai/code/sessi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
2026-10-16 Float the play bar at the bottom of the screen on phones (#17)
    The phone layout's sticky rule never applied (.show-page > :not(.sky) set
    position: relative with higher specificity), so the bar sat at the end of
    the page. It is now fixed over the bottom edge, clear of the home
    indicator via safe-area insets, and the page pads its bottom so the last
    props scroll clear of it. The time readout no longer wraps.
    Claude-Session: https://claude.ai/code/session_019bgx3oUzQzK7ztFMQ8cx4T
2026-11-02 Build runbook page: from ordering to the first test run (#18)
    Adds /runbook.html: nine chapters of to-dos from planning to the test run, a shopping list from the cost model with shop links, order-by dates, private/business tags and subtotals, and optional gear. Ticks are saved in localStorage. Also: ProPixeler 30 cm letters in the model and cost page, blank coro sheets instead of print-shop coro, and full-size coro cutting templates (tools/templates/make.mjs, outputs/templates/).
2026-11-02 Replace the page links with a menu button at the top of every page (#19)
    The show page's 'LED cost estimate' and 'Build runbook' pills and the
    'Back to the light show' links on the other pages make way for one
    festive menu button in the header, listing the light show, the cost
    estimate and the runbook, with the current page starred. On phones the
    button shrinks to an icon, and the show page drops the Winterlight word
    to keep room for the house toggle.
    Claude-Session: https://claude.ai/code/session_01XWmdke8HkEjfkKBmHNKqum
2026-11-06 Show the plan's measurements in the runbook's measuring steps (#20)
    Each measuring step lists what the 2021 plan gives (lengths along the
    facade, opening widths, the garden's width, the garage-to-garden lead)
    and what it can't (heights, forecourt depth, tree spot, bush tops,
    switch location), with the model's guess to check with a tape.
    Claude-Session: https://claude.ai/code/session_01XWmdkdD9enTQv6Ng7ucd9y
2026-11-06 Runbook: the suppliers in the carts, private LEDshows items, boxes in the garage (#22)
    * Show the plan's measurements in the runbook's measuring steps
    * Runbook: buy the controllers and sound card privately
    LEDshows doesn't sell to businesses, so the Baldrick 8 controllers and
    the USB sound card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
2026-11-06 Wiring in the 3D model behind an opening garage door, a wiring plan page, and boxes indoors (#21)
    * Show the wiring in the 3D model as a toggle, and add a wiring plan page
    The model gets a Wiring switch (off by default, ?wiring=1 opens with it on)
    that draws the facade and garden boxes, each controller port's data cable in
    its own colour, power injection points and the network and 230 V feeds from
    indoors. The new wiring plan page (/wiring.html, in the top menu) draws the
    whole setup as one diagram: show computer and switch, both boxes with their
    controller and power supplies, and every port's chain of props to scale, with
    a table per box. Both read src/wiring/plan.js, which is built from t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
2026-11-06 Runbook: shared ticks in Cloudflare D1 behind Access, today's orders pre-ticked, plan revised (#23)
    * Runbook: shared ticks in Cloudflare D1, today's orders pre-ticked, plan revised for the garage boxes
    The runbook's ticks and expense switches now live in a D1 database behind a
    small Worker (/api/runbook), so every device sees the same state. Reads are
    public; writes need the RUNBOOK_KEY secret, entered once per browser.
    Every order placed on 6 Nov (EUR 2,133.10 over nine shops) and the decisions
    already made start ticked. Enclosures, outdoor mains, network cables, the
    switch and the Pi are off the list; the boxes become garage wall boards, the
    FM transmitter runs from a Mean Well, and the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
2026-11-07 Measure page: every tape measurement on the 3D model, saved to D1 and fed into the runbook (#25)
    - /measure.html shows the 11 measurements the plan doesn't give as dimension
    lines on the model (amber with the model's guess, green once measured), with
    a card per measurement to type the value in centimetres.
    - Values go through /api/runbook into a new D1 table (migrations/0002).
    - In the runbook, a measuring step ticks itself once all its values are in,
    tape lines show the measured values, and dependent steps update: outline
    and ground strip pixel counts, whether the strings and mounting strip
    ordered still cover the show, ladder height, and the letter, tree and
    mini-tree fit check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
2026-11-07 3D prints page: PETG parts for the garden props, with the finished props in 3D (#26)
    * 3D prints page: PETG parts for the garden props, designed in OpenSCAD for the Bambu A1
    Mini-tree base rings and top caps, the wireframe tree's crown hub, star
    holder and strand pegs, candy cane stakes and two-piece ground strip posts.
    Sizes come from the house model; tools/print/make.mjs renders the STLs, a
    manifest and a zip. The page shows each part on the A1 bed in 3D, is in the
    top menu, and the runbook's build steps link to it.
    Claude-Session: https://claude.ai/code/session_01XWmdkfa4ZbGvqYgA3x2az3
    * 3D prints: brick-weighted feet instead of s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
2026-11-08 Runbook: garage socket has no working 30 mA RCD, add a plug-in RCD and an electrician step (#27)
    The RCD check found circuit S only behind the 300 mA main, and the old
    30 mA Merlin Gerin failed its test. Add a PRCD to the shopping list, an
    electrician step with replacement parts, and say so on the wiring page.
    Claude-Session: https://claude.ai/code/session_01XWmdkfQsfmsCaXPXwd4fXx
2026-11-08 Model: taped measurements in the 3D model, and two more on the measure page (#28)
    * Model: the taped heights, garden depth and planting tiles from the measure page
    The house model now carries the 11 measurements entered on 8 Nov 2026:
    door 2.10 m, garage door 2.12 m, kitchen window 1.21 m, small window 0.76 m,
    upstairs windows 3.65-5.15 m, garage eave 2.86 m, letter band 1.55 m,
    garden 3.91 m deep, tile gaps 76/80 cm, bush tops 60 cm. The props follow
    (outlines, strips, letters, wreaths, tree, canes, ground strip, mini trees).
    The model's earlier guesses and the order baseline (2,399 pixels, 51
    strings, 2 rolls) are now fixed values in src/measures/measures.js, so the
    measure page and runb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
2026-11-09 Runbook: LEDshows and Elektramat parcels arrived on 9 Nov (#30)
    Delivery steps can carry an arrival date: they start ticked and show
    "Arrived" instead of "Expected".
    Claude-Session: https://claude.ai/code/session_01XWmdkgCuN8cdbnZ9yVjjGG
2026-11-10 Model: the last two taped measurements (#34)
    The last two taped values. The kitchen window moves up 6 cm; the tiles,
    the tree and the mini trees move 6 cm toward the street, leaving the back
    tiles 14 cm short of the cane line. Pixel counts don't change.
    Claude-Session: https://claude.ai/code/session_01XWmdkephc5uuykB85EoCFM
2026-11-10 Garden box outdoors, materials checked against the plan (#35)
    - Cost model: the garden controller and its supplies move to an IP65 box
    behind the front-left bush, fed by mains and network from the garage; the
    facade board stays in the garage with a metre of cable to the hole.
    - Cable hops are measured from where a prop's data ends to where the next
    starts, with the extensions inside the window outlines; injection wire comes
    from each run's real length; the mini-tree spokes count as mounting strip.
    - Props wired in build order: outlines from the garage door, eave strip from
    its right end, tree strands and mini-tree spokes up one and down the next.
    - Runbook: orders of 6 Nov keep wha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
2026-11-11 Raise the upper strip so its icicles clear the built-in shutters (#36)
    * Raise the upper strip so its icicles clear the built-in shutters
    All upstairs and ground-floor windows except the small one by the garage
    have roller shutters built into the wall. The upper strip now hangs 27 cm
    above the upstairs window tops (about 5.42 m, under the 5.5 m eaves), so
    its icicles end above the shutter boxes. The runbook says to fix nothing
    to shutter boxes or guides, to test the shutters after hanging, and to
    keep the upstairs shutters up during show hours for the circles.
    Claude-Session: https://claude.ai/code/session_01XWmdkdWH3JkS4YQA29Cbwc
    *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
2026-11-11 Show software page: data diagram, services and the show-file plan (#37)
    A new public page, /software.html, in the top menu: how the Pi with Falcon
    Player, the switch, both Baldrick 8 controllers and the FM transmitter are
    connected, what runs where, and the proposed conversion from the detected
    cue file to a 40 fps .fseq over DDP, with what is still to decide.
    Claude-Session: https://claude.ai/code/session_01XWmdkeTb6Z4qoHeNdYqydh
2026-11-12 Runbook: deliveries not ordered yet no longer show as expected (#39)
    A delivery step now lists the order steps it holds and shows 'Not ordered
    yet' until all of them are ticked. The installation parts from bol.com,
    Elektramat, LEDshows and AliExpress have not been ordered, so they stop
    showing an expected date; the Elektramat Wago reorder (placed 10 Nov) stays
    expected.
    Claude-Session: https://claude.ai/code/session_01XWmdkdHaorb1TQCNbG3Hd5
2026-11-12 Runbook: link every installation part to its product page (#40)
    The "Buy the installation parts" chapter linked the DIY store, Elektramat
    and AliExpress by homepage or search. Each part now links straight to a
    product page (Gamma, Hubo, Elektramat, Zelektro, bol.com, LEDshows,
    AliExpress, Boels). Sets get extra links for their other items, and local
    parts name the store. The PRCD gets the exact Belgian article at Zelektro.be
    for €29.25. A test keeps the chapter free of homepage and search links.
    Claude-Session: https://claude.ai/code/session_01XWmdkgX4WA3nYoFwpR14i7
2026-11-12 Runbook: add a Cut and drill the tree star step (#41)
    Claude-Session: https://claude.ai/code/session_01XWmdkh6qGbVbDk26GVuGvq
2026-11-13 Runbook: Elektramat reorder, ProPixeler and Audiophonics arrived on 13 Nov (#42)
    * Runbook: the Elektramat gel box reorder, ProPixeler letters and Audiophonics power supplies arrived on 13 Nov
    Claude-Session: https://claude.ai/code/session_01XWmdkgyPY8dhwayJrnwVgw
    * Runbook: mains leads for the four power supplies
    Claude-Session: https://claude.ai/code/session_01XWmdkgyPY8dhwayJrnwVgw
    ---------
2026-11-13 Runbook: correct the garden box to the Rittal AX 1034.000 (IP66), cheapest at Elektramat.nl (#44)
    * Runbook: garden box is the Rittal AX 1034.000 (IP66), priced at RS Belgium
    The entry said 'IP65, about 400 × 300 × 170 mm, with M20 glands' at an
    estimated €95, but the linked box is Rittal's AX 1034.000: IP66 and UL
    Type 3R/4, 300 × 400 × 210 mm, glands sold separately. Name, size and
    rating now match Rittal's data sheet; price is RS Belgium's €104.72
    excl. VAT (in stock), with Elektramat kept as an alternative link.
    Claude-Session: https://claude.ai/code/session_01XWmdkfvDG4BjP2BkQzkviP
    * Runbook: garden box from Elektramat.n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
2026-11-13 Runbook: fix the outstanding shopping list after a link and price audit (#45)
    * Runbook: audit the outstanding shopping list (links, specs, cheapest prices)
    Fix the garden mains link (3x25 -> 3G2.5) and plug, make the PSU leads from
    real Gamma parts, cheaper zinc screw eyes with 5 mm plugs, Brico anchors,
    real prices for the pole, ladder, rods, bars and connector care. The parasol
    base and bricks are optional (likely borrowed); the masonry bit and network
    cable are already at hand. Widen the mini-tree rod hole to 12 mm and the cane
    slot for its aluminium stiffener, and re-render those STLs.
    * Runbook: stainless screw eyes for the facade, since they stay out all winter
    Co-author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
2026-11-13 Runbook: record the 13 Nov LEDshows strip and AliExpress pigtail orders, drop the extra cable pack (#46)
2026-11-14 Runbook: record the 14 Nov Kiwi Pi order; the Pi 4 runs the show (#47)
    * Show software page: data diagram, services and the show-file plan
    * Runbook: record the 14 Nov Kiwi Pi order as business gear outside the show's spend
    Pi 5 8 GB, Pi 4 4 GB, cases, power supplies and two 6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
2026-11-14 Runbook: collapsible chapters that fold once finished, and a price toggle (#50)
    Click a chapter header (or its chevron) to open or close it. A chapter folds
    shut a moment after its last step is ticked and opens again if a step is
    unticked. Prices, item costs and totals are hidden until 'Show prices' is
    switched on; the choice is kept per browser.
    Claude-Session: https://claude.ai/code/session_01XWmdkeHRQtphvh8Jdy6oFr
2026-11-14 Runbook: the Zelektro PRCD is a business expense, like every Elektramat part (#49)
    Pi 5 8 GB, Pi 4 4 GB, cases, power suppli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
